HongMinhNhat35/ProtocampSavox/savoxcasev2.3mf

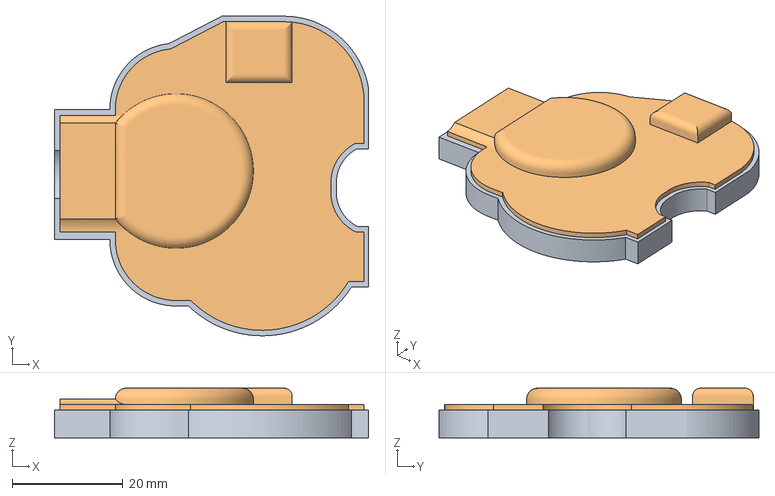
[picture p26: CAD file, 2024-08-29]
savoxcasev2.3mf
56.8 x 57.8 x 9.00 mm
