HongMinhNhat35/ProtocampSavox/noise-collector/noice-collector.kicad_pcb

## KiCad design adapter.kicad_sch

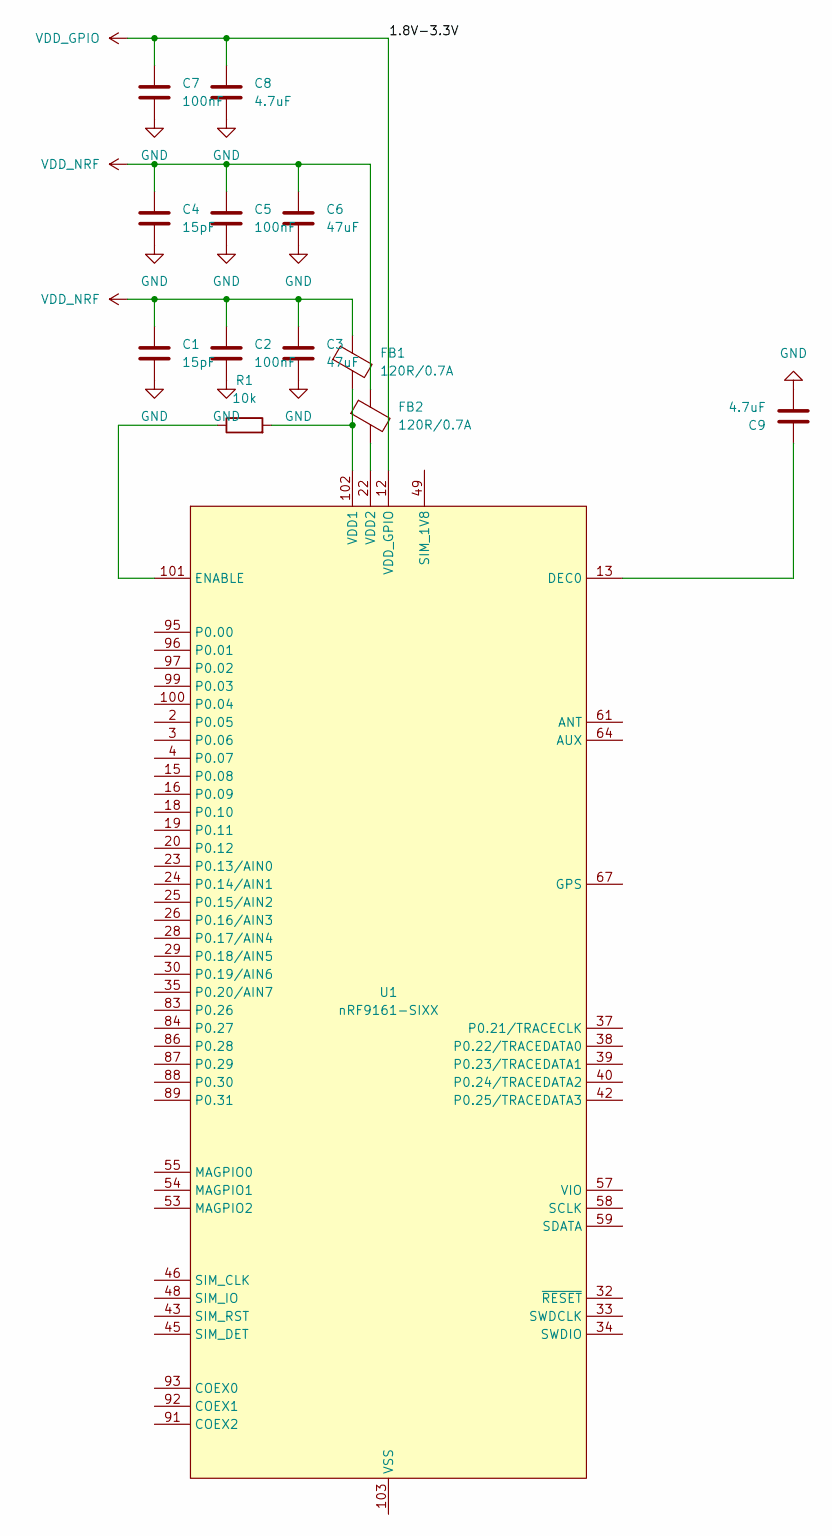
[picture p27: schematic adapter.kicad_sch]

Parts:
C1, C4: 15pF
C2, C5, C7: 100nF
C3, C6: 47uF
C8, C9: 4.7uF
FB1, FB2: 120R/0.7A
R1: 10k
U1: nRF9161-SIXX; LGA_9161_16.0x10.5mm

Connections:
GND: C1.2, C2.2, C3.2, C4.2, C5.2, C6.2, C7.2, C8.2, C9.2
unnamed: C9.1, U1.13 (DEC0)
unnamed: FB1.2, R1.2, U1.102 (VDD1)
unnamed: FB2.2, U1.22 (VDD2)
unnamed: R1.1, U1.101 (ENABLE)
unnamed: U1.1 (GND_Shield), U1.5 (GND_Shield), U1.6 (GND_Shield), U1.7 (GND_Shield), U1.8 (GND_Shield), U1.9 (GND_Shield), U1.11 (GND_Shield), U1.14 (GND_Shield), U1.17 (GND_Shield), U1.21 (GND_Shield), U1.27 (GND_Shield), U1.31 (GND_Shield), U1.36 (GND_Shield), U1.41 (GND_Shield), U1.44 (GND_Shield), U1.47 (GND_Shield), U1.50 (GND_Shield), U1.52 (GND_Shield), U1.56 (GND_Shield), U1.60 (GND_Shield), U1.62 (GND_Shield), U1.63 (GND_Shield), U1.65 (GND_Shield), U1.66 (GND_Shield), U1.68 (GND_Shield), U1.69 (GND_Shield), U1.72 (GND_Shield), U1.74 (GND_Shield), U1.75 (GND_Shield), U1.76 (GND_Shield), U1.77 (GND_Shield), U1.78 (GND_Shield), U1.79 (GND_Shield), U1.80 (GND_Shield), U1.81 (GND_Shield), U1.82 (GND_Shield), U1.85 (GND_Shield), U1.90 (GND_Shield), U1.94 (GND_Shield), U1.98 (GND_Shield), U1.103 (VSS)
VDD_GPIO: C7.1, C8.1, U1.12 (VDD_GPIO)
VDD_NRF: C1.1, C2.1, C3.1, C4.1, C5.1, C6.1, FB1.1, FB2.1
