HongMinhNhat35/ProtocampSavox/(commit log)

2024-08-19 Update main.ino
    this is the code that use ADC manipulation to control ULP without
    addtional setup. The mic is also attenuate and have error range of 5 to 10 DBA. The wifi credentials is hard code to aalto open.
    [main.ino]
2024-08-29 Update main.ino
    final code with calibration to the microphoned
